janisstreib/sciencecamp_2019-datalogger/pcb/sciencecamp_logger.kicad_pcb

## KiCad design pcb/sciencecamp_logger.kicad_pcb (2019-07-19)

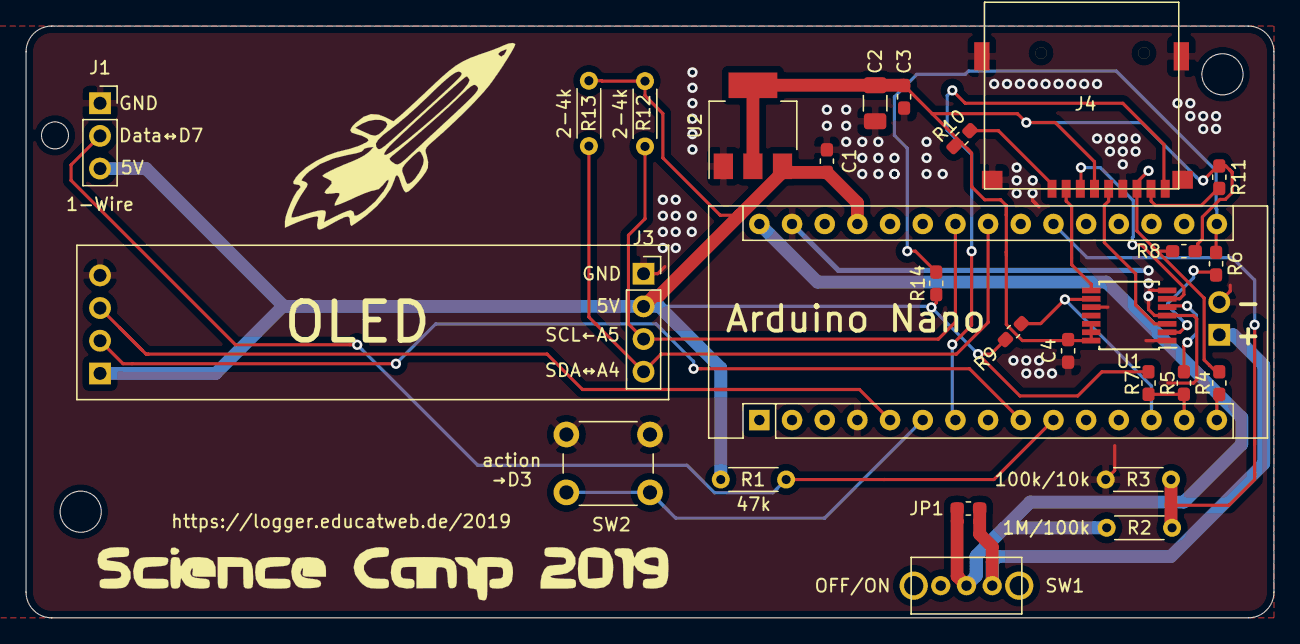
[picture p1: board sciencecamp_logger.kicad_pcb from above]

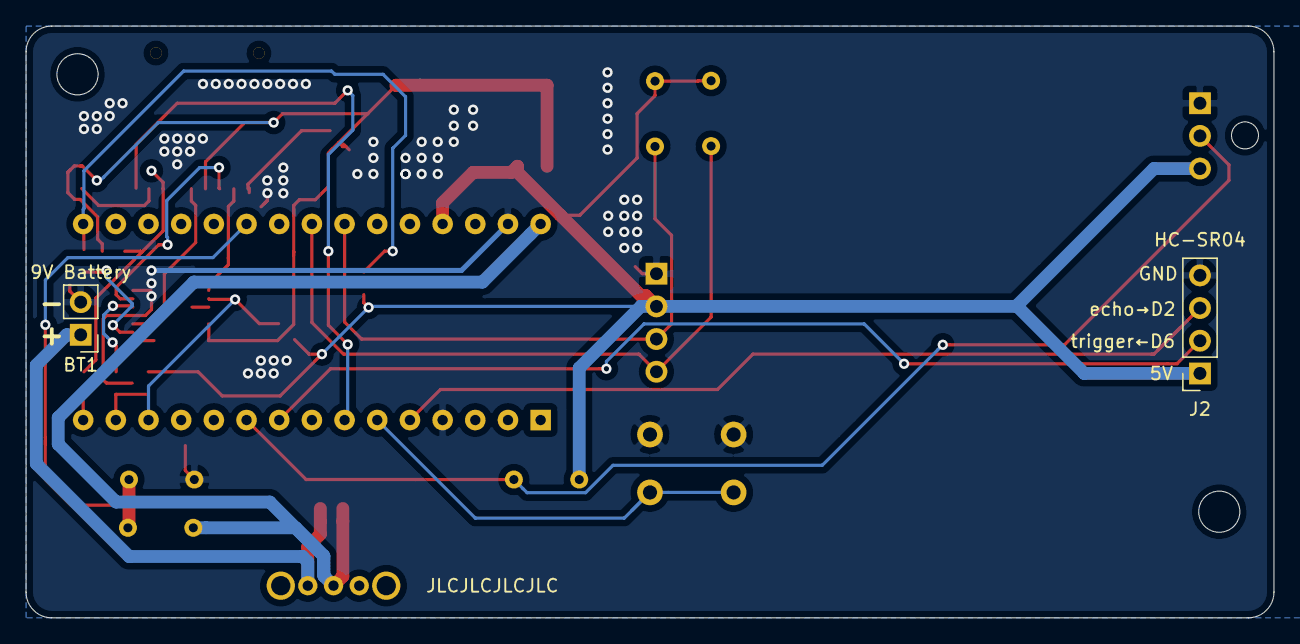
[picture p2: board sciencecamp_logger.kicad_pcb from below]

Board: 2 copper layers, 97.0 x 46.0 mm, 29 parts (2 on the bottom side), 25 nets.

Parts:
A1: Arduino Nano; Arduino_Nano
BT1: 9V Battery; PinHeader_1x02_P2.54mm_Vertical
C1, C3: 0.01uF; C_0603_1608Metric_Pad1.05x0.95mm_HandSolder
C2: 10uF; C_1206_3216Metric
C4: 0.1u; C_0603_1608Metric_Pad1.05x0.95mm_HandSolder
J1: 1-Wire; PinSocket_1x03_P2.54mm_Vertical
J2: HC-SR04; PinSocket_1x04_P2.54mm_Vertical
J3: OLED; 12832_SSD1306
J4: Micro_SD_Card_Det; SOFNG_TF-15_15
JP1: switch_bypass; R_0603_1608Metric_Pad1.05x0.95mm_HandSolder
R1: 47k; R_Axial_DIN0204_L3.6mm_D1.6mm_P5.08mm_Horizontal
R2: 1M/100k; R_Axial_DIN0204_L3.6mm_D1.6mm_P5.08mm_Horizontal
R3: 100k/10k; R_Axial_DIN0204_L3.6mm_D1.6mm_P5.08mm_Horizontal
R4, R5, R6: 0; R_0603_1608Metric_Pad1.05x0.95mm_HandSolder
R7: 47/70k; R_0603_1608Metric_Pad1.05x0.95mm_HandSolder
R8, R10, R11: 47/50k; R_0603_1608Metric_Pad1.05x0.95mm_HandSolder
R9, R14: 47k/50k; R_0603_1608Metric_Pad1.05x0.95mm_HandSolder
R12, R13: 2-4k; R_Axial_DIN0204_L3.6mm_D1.6mm_P5.08mm_Horizontal
SW1: OFF/ON; OS102011MA1QN1
SW2: action; SW_PUSH_6mm_H13mm
U1: 74LVC125; TSSOP-14_4.4x5mm_P0.65mm
U2: AMS1117-3.3; SOT-223-3_TabPin2

Connections:
+5V: A1.27, C1.1, J1.3, J2.1, J3.2, R1.1, R7.2, R9.1, R12.1, R13.1, R14.1, U2.3
/ECHO: A1.5, J2.3
/SCL: A1.24, J3.3, R12.2
/SDA: A1.23, J3.4, R13.2
/TRIGGER: A1.9, J2.2
GND: A1.4, A1.29, BT1.2, C1.2, C2.2, C3.2, C4.2, J1.1, J2.4, J3.1, J4.6, J4.11, R3.2, SW2.1, U1.1, U1.4, U1.7, U1.10, U2.1
MISO: A1.15, R4.2
MOSI: A1.14, R5.2, R7.1
unnamed: A1.6, SW2.2
unnamed: A1.10, J1.2, R1.2
unnamed: A1.21, R2.2, R3.1
unnamed: A1.30, JP1.1, R2.1, SW1.2
unnamed: BT1.1, JP1.2, SW1.3
unnamed: J4.1, R10.2
unnamed: J4.2, U1.8
unnamed: J4.3, U1.6
unnamed: J4.5, U1.3
unnamed: J4.7, R4.1, R8.2
unnamed: J4.8, R11.2
unnamed: R5.1, U1.5
unnamed: R6.1, U1.2
SD_3V3: C2.1, C3.1, C4.1, J4.4, R8.1, R10.1, R11.1, U1.12, U1.13, U1.14, U2.2
SD_DETECT: A1.7, J4.10
SD_SS: A1.13, R9.2, U1.9
SPI_SCK: A1.16, R6.2, R14.2
