janisstreib/sciencecamp_2019-datalogger/(commit log)

2019-06-08 init: pcb
    [sciencecamp_logger.kicad_pcb, sciencecamp_logger.sch]
2019-06-08 UPD: renamed folder
    [sciencecamp_logger.kicad_pcb, sciencecamp_logger.sch]
2019-06-09 UPD: More GND-surface for bat minus
    [sciencecamp_logger.kicad_pcb]
2019-06-09 FIX: correct pullup and connected all buffer inputs
    [sciencecamp_logger.kicad_pcb, sciencecamp_logger.sch]
2019-06-09 ADD: additional pullups
    [sciencecamp_logger.kicad_pcb, sciencecamp_logger.sch]
2019-06-09 FIX: overlapping slikscreen
    [sciencecamp_logger.kicad_pcb]
2019-06-09 ADD: url
    [sciencecamp_logger.kicad_pcb]
2019-06-09 UPD: more THT
    [sciencecamp_logger.kicad_pcb, sciencecamp_logger.sch]
2019-06-09 UPD: respositioned text
    [sciencecamp_logger.kicad_pcb]
2019-07-02 FIX: server layout issues
    - wrong pin order for sc-card slot
    - wrong pin order for ultrasonic sensor
    - wrong footprint for 10uF cap
    - missing pads for switch footprint
    - missing level convertion for spi chip select
    - unnecessary level conversion for miso
    [sciencecamp_logger.kicad_pcb, sciencecamp_logger.sch]
2019-07-02 Slight fixes
    [sciencecamp_logger.kicad_pcb, sciencecamp_logger.sch]
2019-07-03 Small fixes
    [sciencecamp_logger.kicad_pcb]
2019-07-04 FIX: correct label and location
    [sciencecamp_logger.kicad_pcb, sciencecamp_logger.sch]
2019-07-09 ADD: strain relief for one-wire sensor
    [sciencecamp_logger.kicad_pcb]
2019-07-11 FIX: mixed up ultrasonic pins
    [sciencecamp_logger.kicad_pcb, sciencecamp_logger.sch]
2019-07-19 CLN: refill
    [sciencecamp_logger.kicad_pcb]
2019-07-19 ADD: jlcpcb customer id
    [sciencecamp_logger.kicad_pcb]
2019-08-09 FIX: imporved performance for temperatrure readings
    [Logger.cpp]
2019-08-11 FIX: don't output time in serial output
    [Logger.cpp]
2019-08-11 FIX: memory optimization, overflow bug, loading screen
    [Logger.cpp, Logger.h, firmware.ino]
